ffpp2003/NPC/images/renders/ER3.png

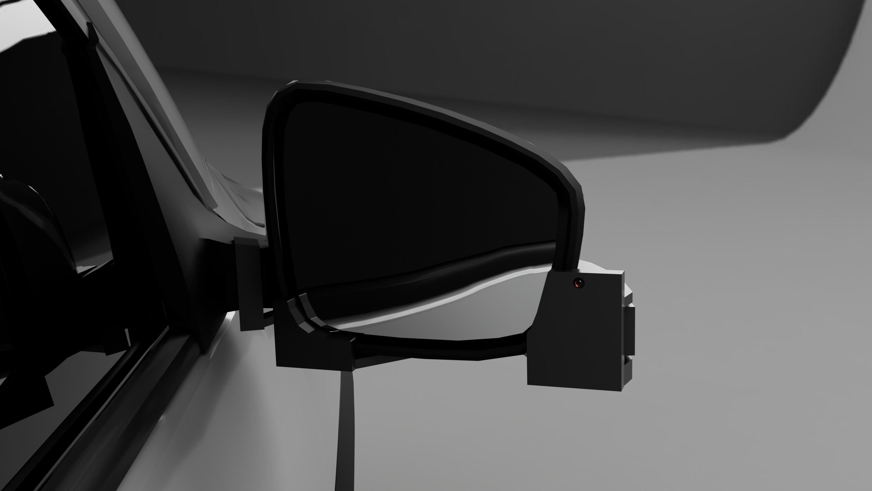
images/renders/ER3.png
