ffpp2003/NPC/images/renders/AL2.png

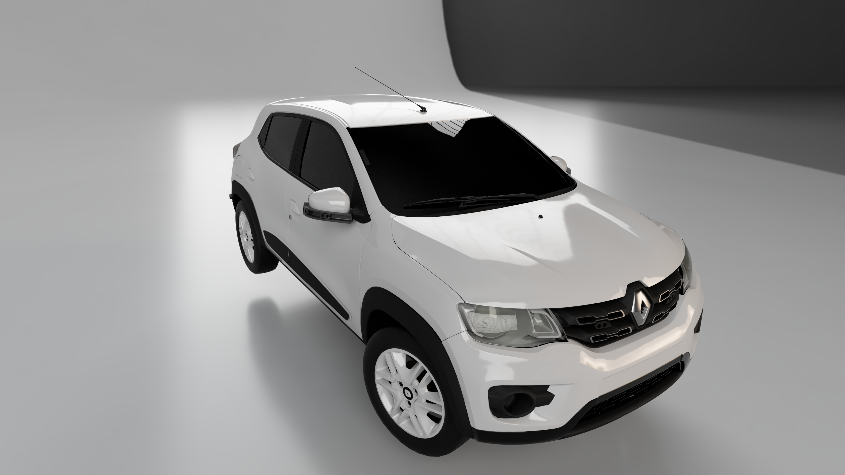
images/renders/AL2.png
