ffpp2003/NPC/README.md

# NPC
Demostracion conceptual funcional de un neutralizador de puntos ciegos para autos
