ffpp2003/NPC/images/renders/AL0.png

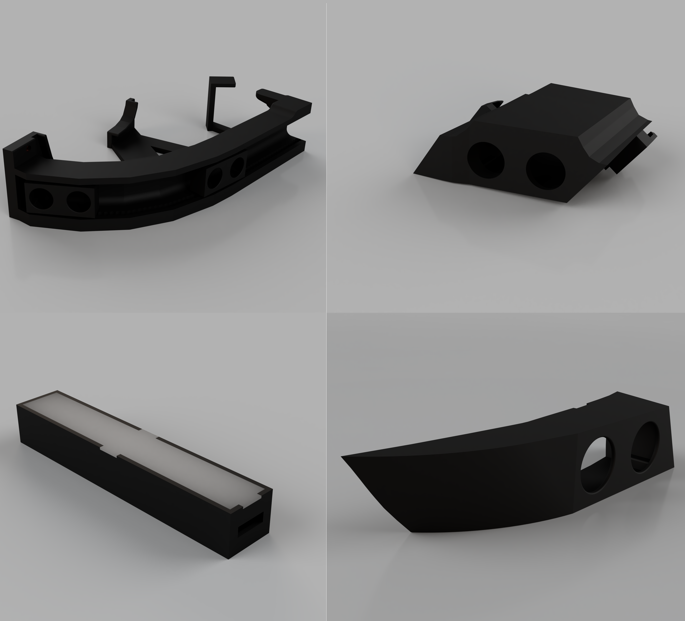
images/renders/AL0.png
