ffpp2003/NPC/images/renders/AL1.png

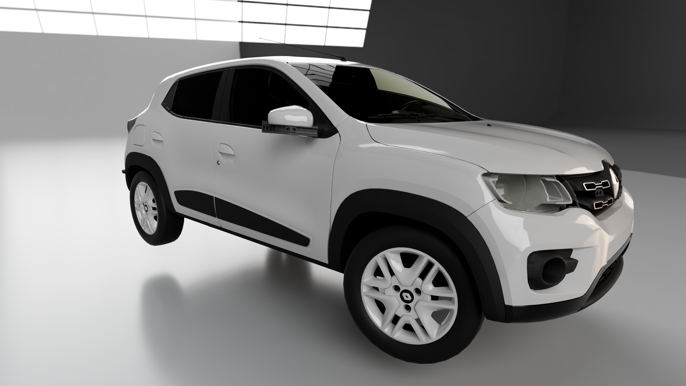
images/renders/AL1.png
