ffpp2003/NPC/images/renders/ER0.png

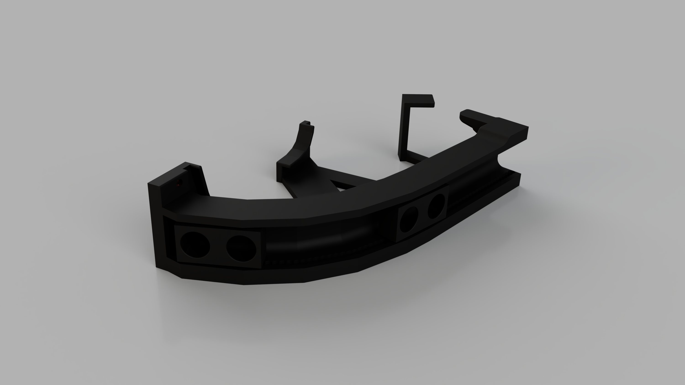
images/renders/ER0.png
