ffpp2003/NPC/images/renders/ER1.png

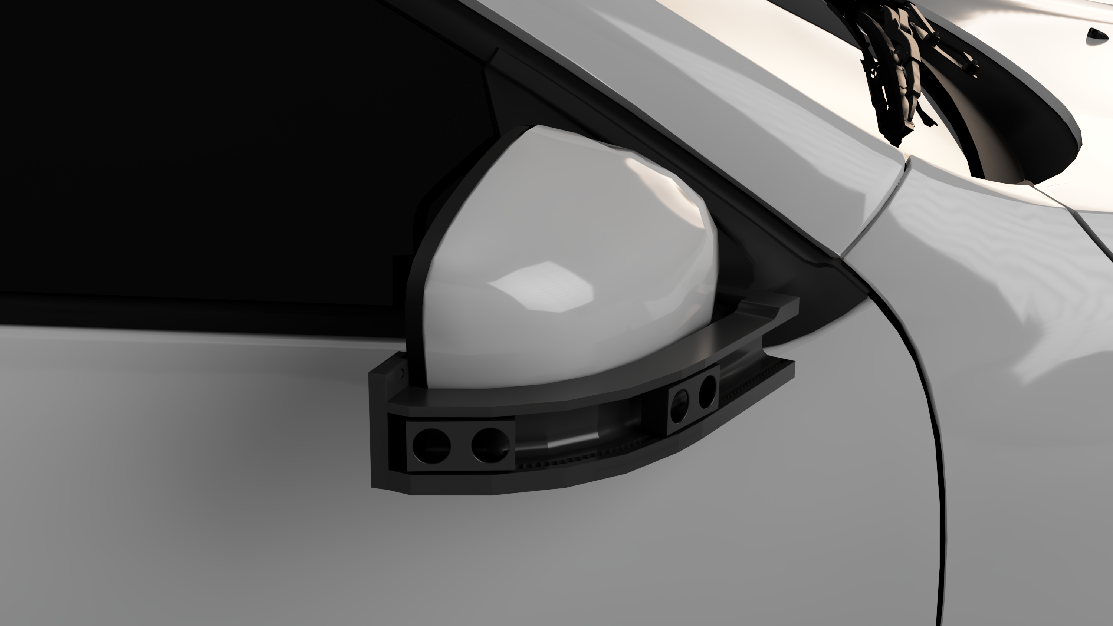
images/renders/ER1.png
