ffpp2003/NPC/images/renders/ER2.png

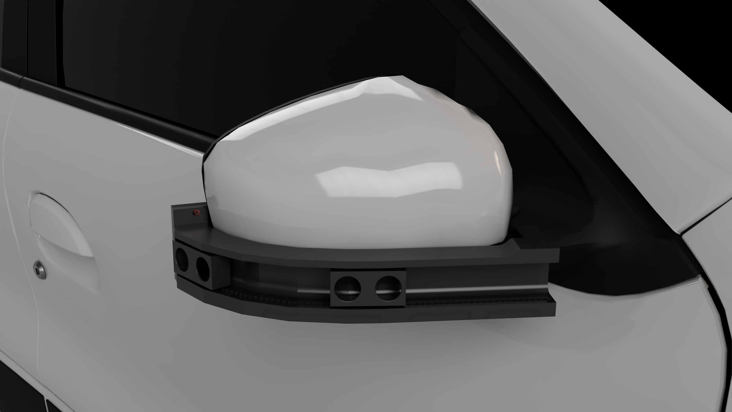
images/renders/ER2.png
