ffpp2003/NPC/images/renders/ER4.png

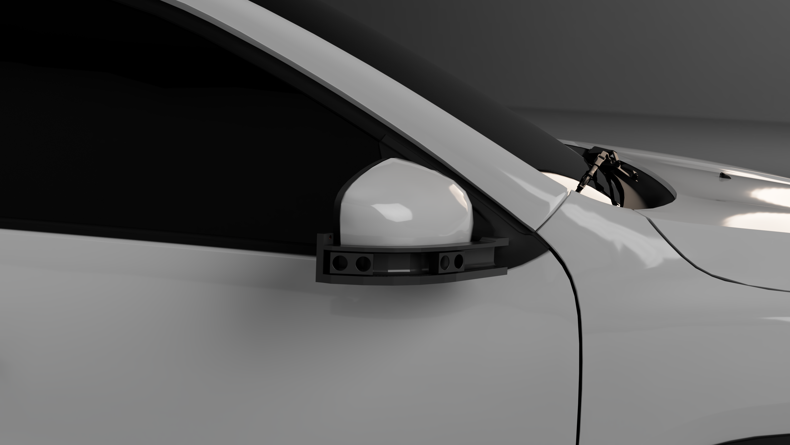
images/renders/ER4.png
