ffpp2003/NPC/images/renders/ER5.png

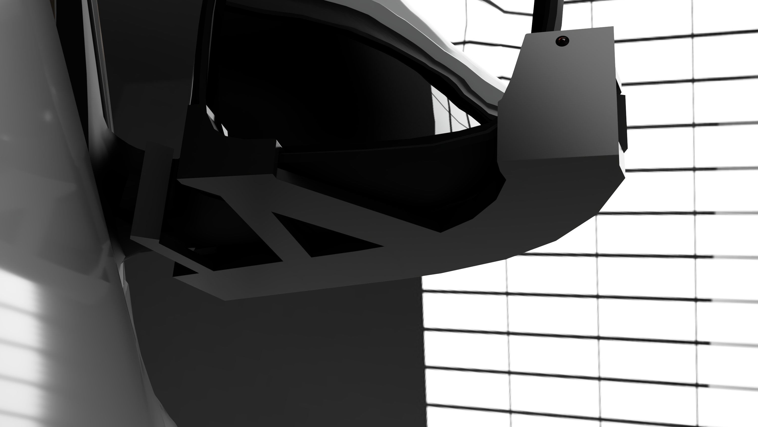
images/renders/ER5.png
