ffpp2003/NPC/images/renders/OP0.png

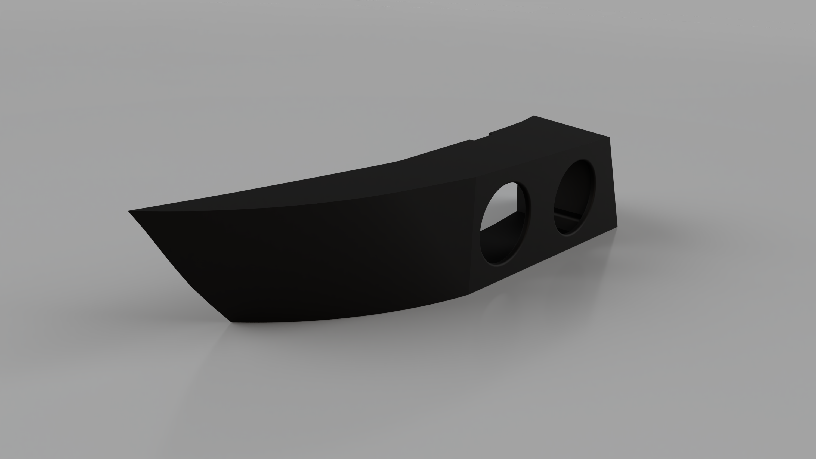
images/renders/OP0.png
