ffpp2003/NPC/images/renders/OP1.png

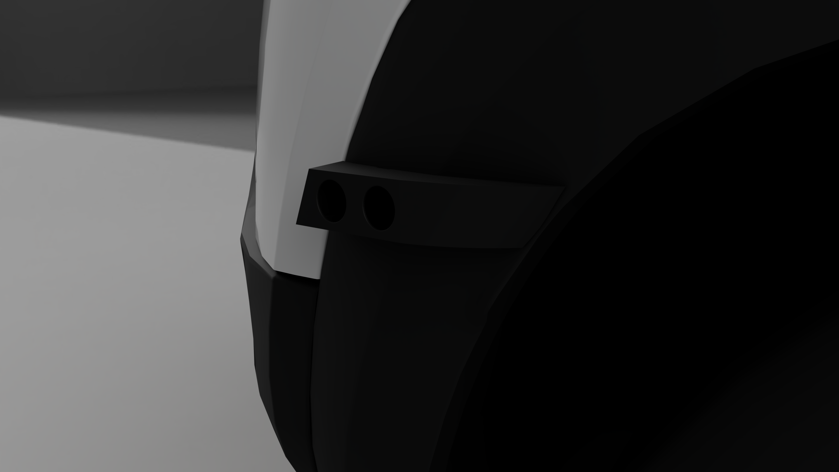
images/renders/OP1.png
