ffpp2003/NPC/images/renders/OP2.png

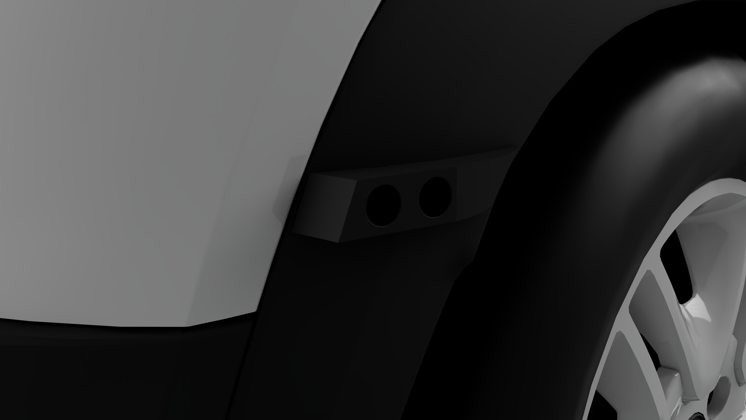
images/renders/OP2.png
