ffpp2003/NPC/images/renders/OP3.png

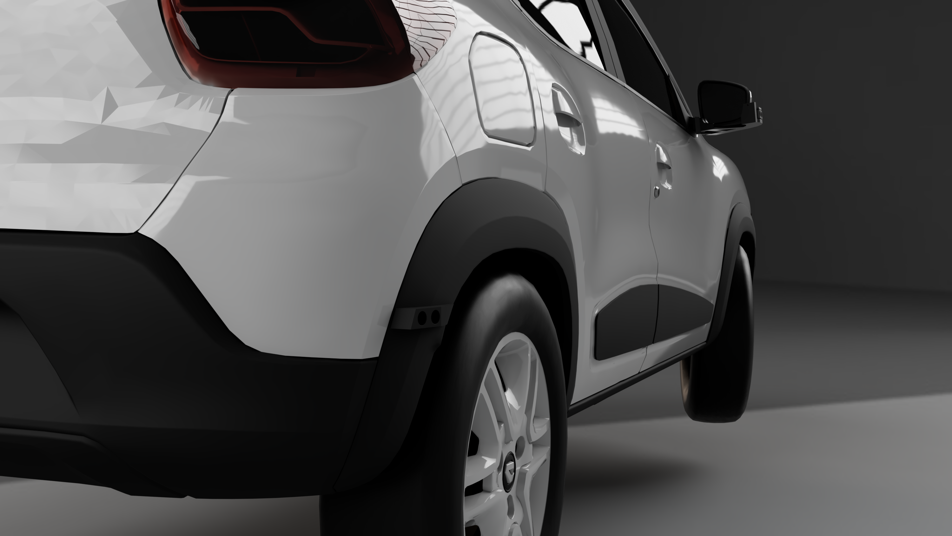
images/renders/OP3.png
