ffpp2003/NPC/images/renders/PCBL.png

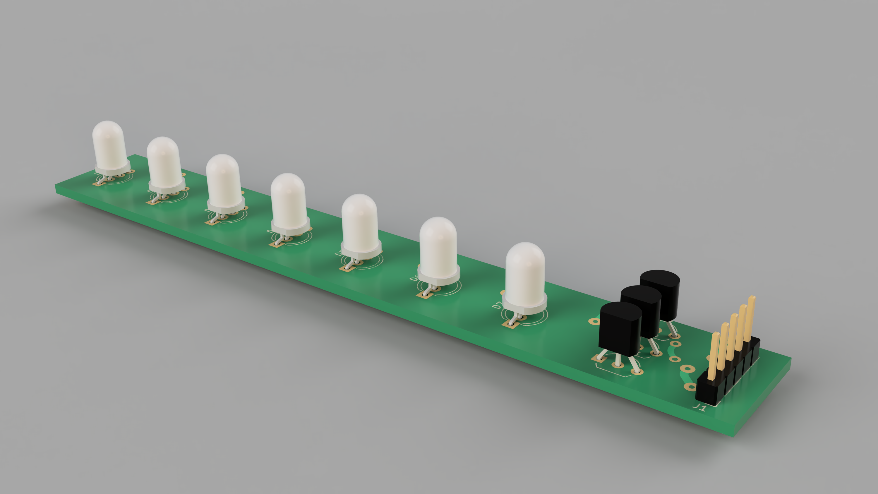
images/renders/PCBL.png
