ffpp2003/NPC/images/renders/PCBM.png

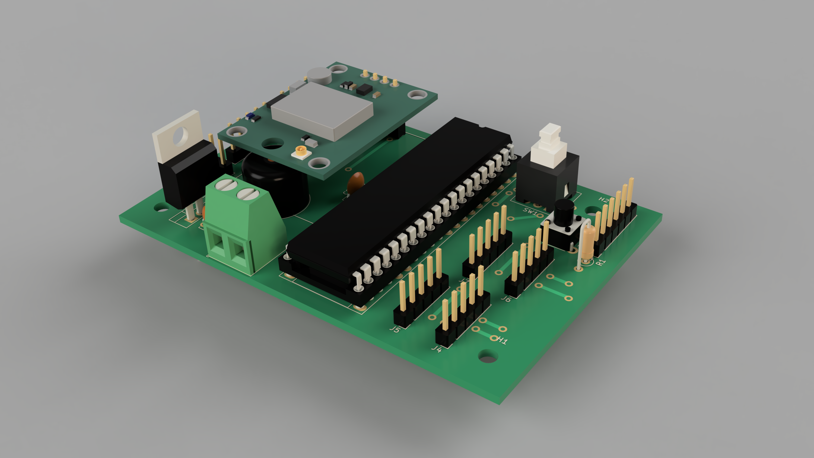
images/renders/PCBM.png
