ffpp2003/NPC/images/renders/PF0.png

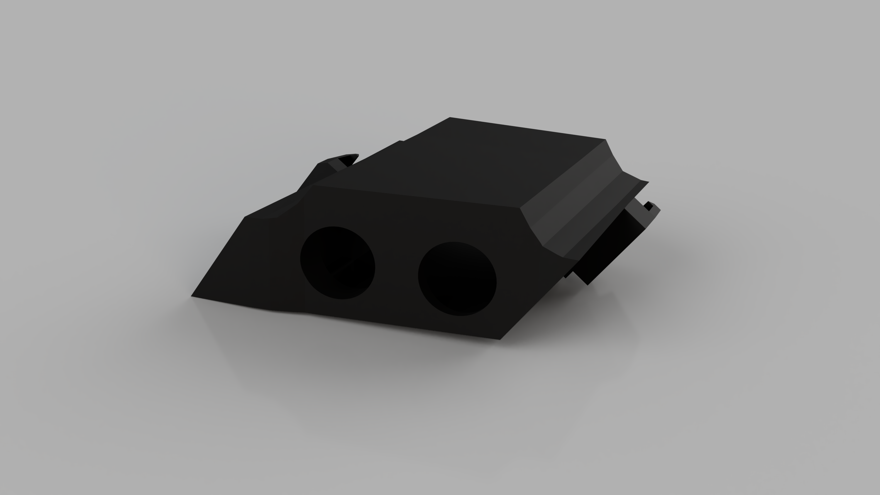
images/renders/PF0.png
