ffpp2003/NPC/images/renders/PF1.png

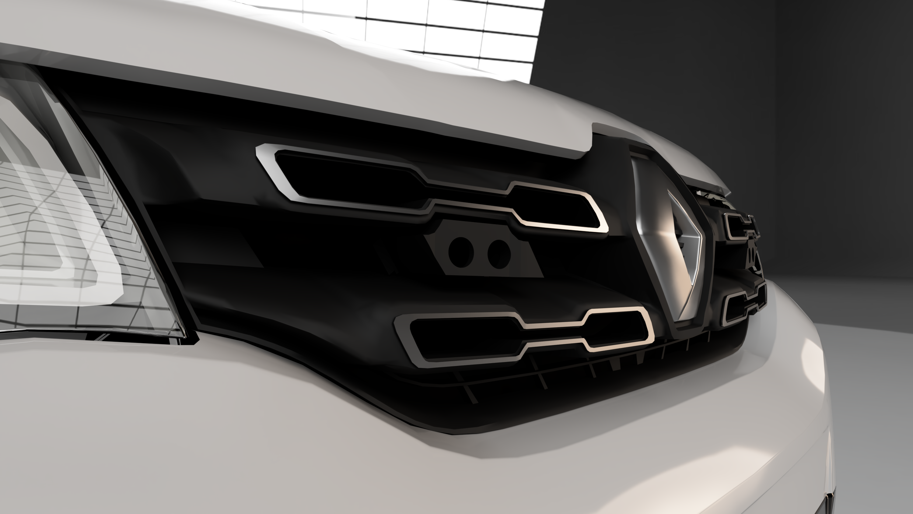
images/renders/PF1.png
