ffpp2003/NPC/images/renders/PF2.png

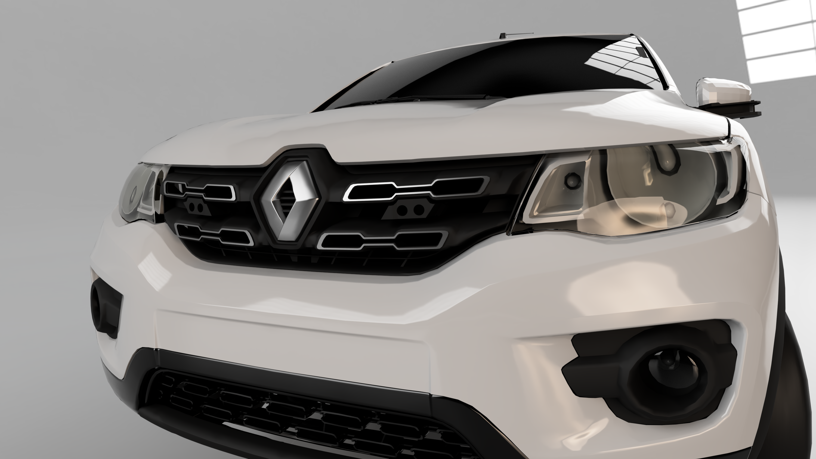
images/renders/PF2.png
