ffpp2003/NPC/images/renders/SL0.png

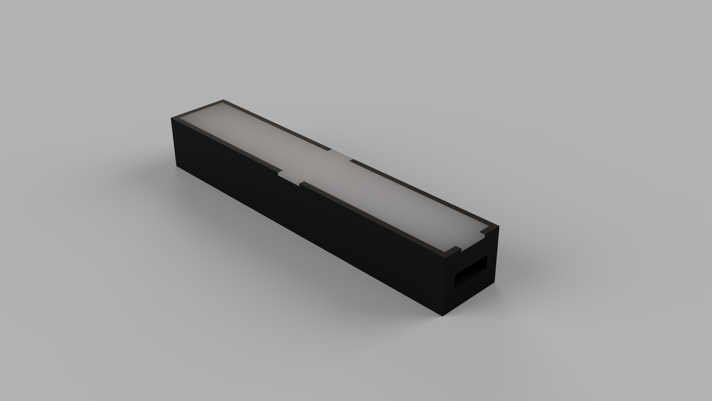
images/renders/SL0.png
