ffpp2003/NPC/images/renders/SL1.png

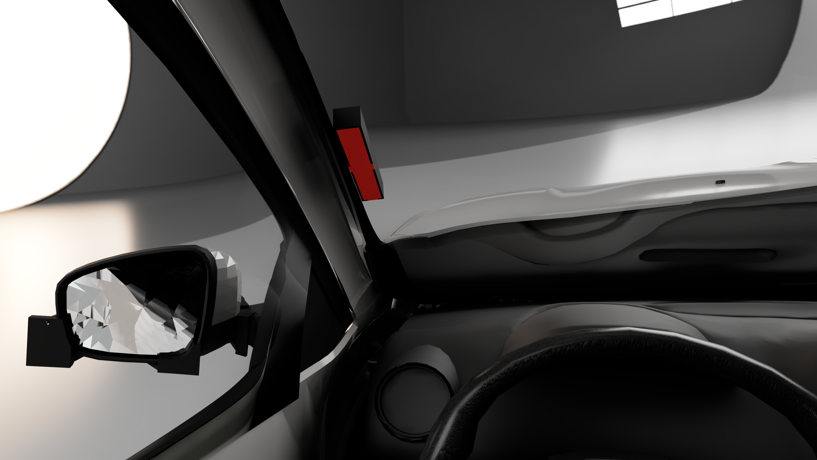
images/renders/SL1.png
