ffpp2003/NPC/images/renders/SL2.png

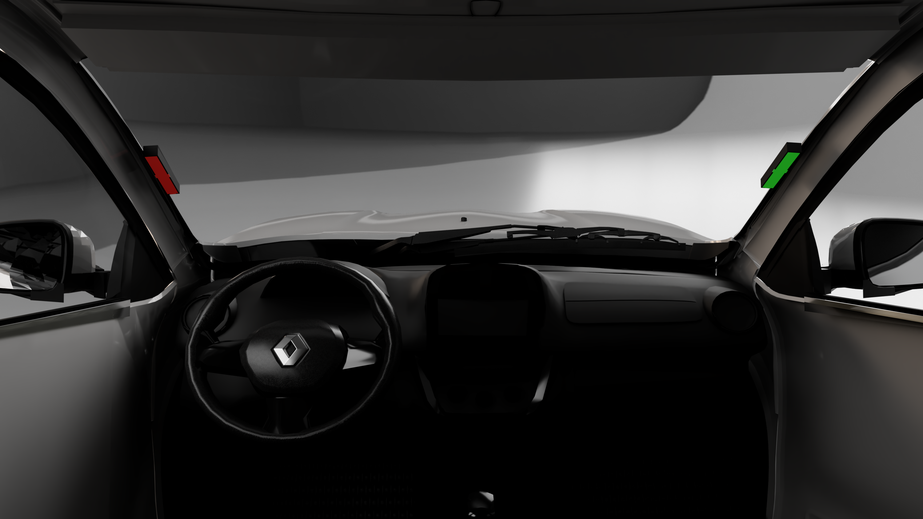
images/renders/SL2.png
