ffpp2003/NPC/src/Detector de puntos ciegos/GPS_ublox_board.STEP

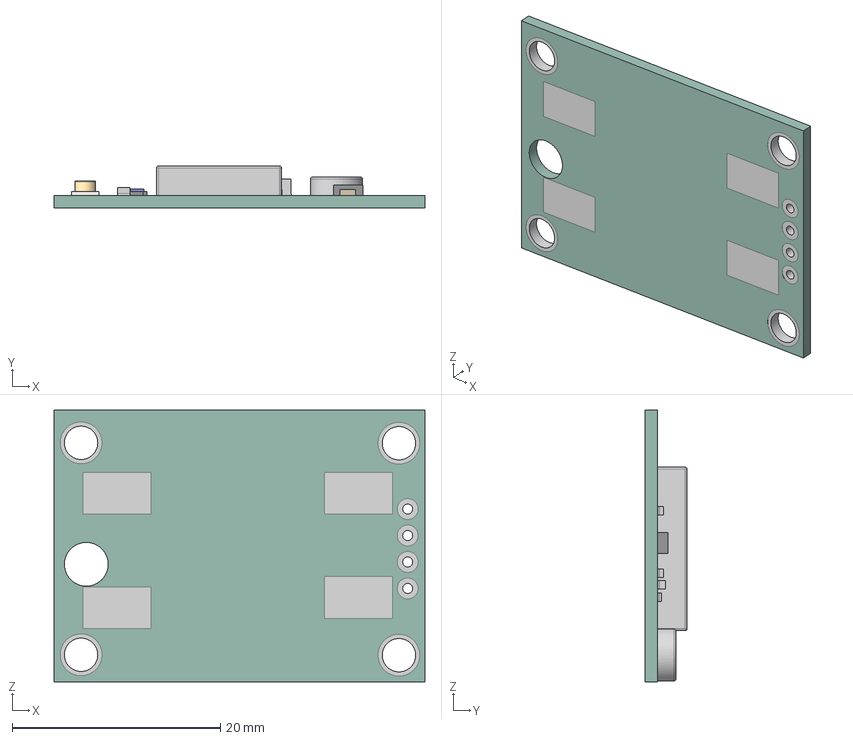
[picture p31: CAD file, 2022-11-30]
src/Detector de puntos ciegos/GPS_ublox_board.STEP
35.6 x 4.06 x 26.1 mm
