ffpp2003/NPC/src/PCB_LEDS/LED_D5.0mm-4_RGB_Wide_Pins-Body001.step

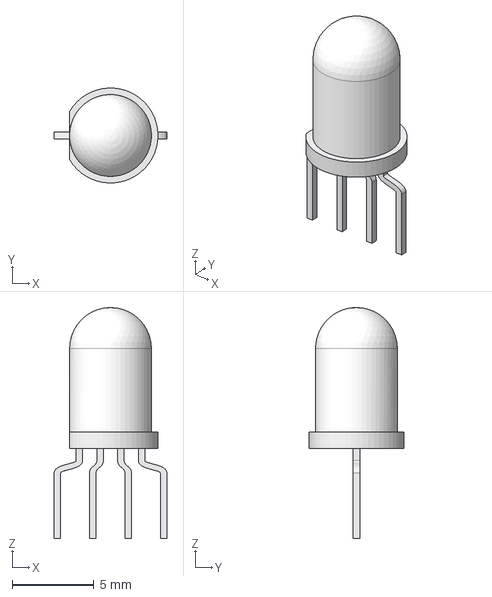
[picture p32: CAD file, 2022-11-30]
src/PCB_LEDS/LED_D5.0mm-4_RGB_Wide_Pins-Body001.step
6.88 x 5.79 x 14.1 mm
