ffpp2003/NPC/src/Detector de puntos ciegos/TL2230EEF100--3DModel-STEP-613395_2.step

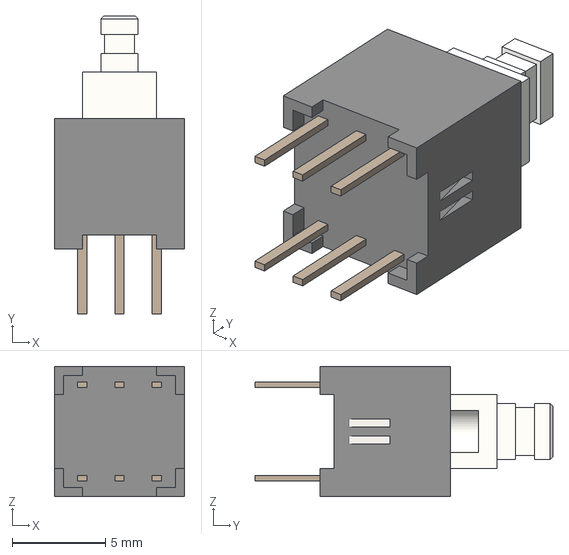
[picture p33: CAD file, 2022-11-30]
src/Detector de puntos ciegos/TL2230EEF100--3DModel-STEP-613395_2.step
7.00 x 16.0 x 7.00 mm
