ffpp2003/NPC/src/Detector de puntos ciegos/ublox NEO-6M.STEP

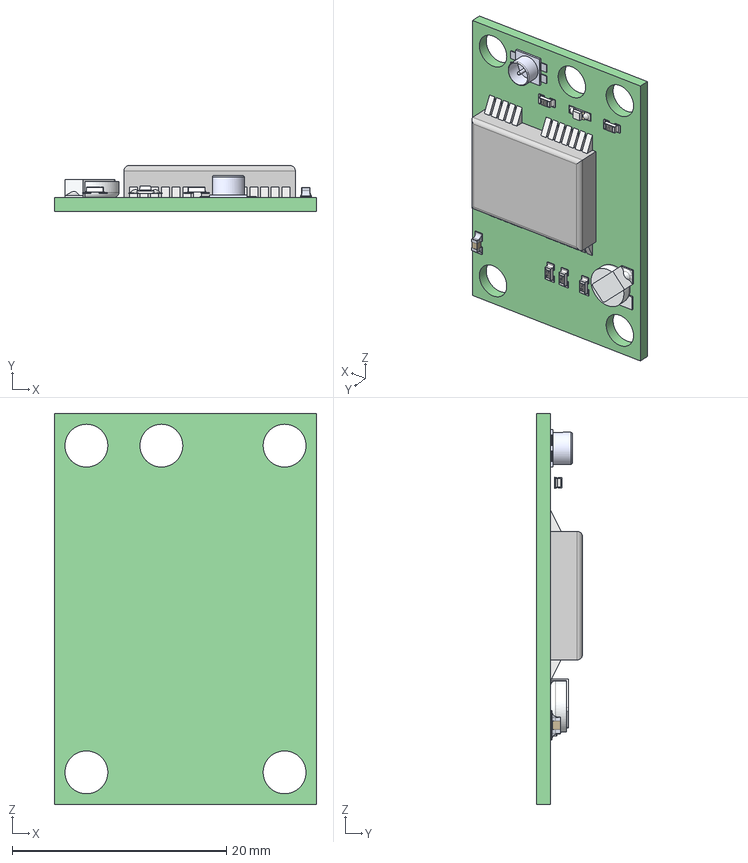
[picture p34: CAD file, 2022-11-30]
src/Detector de puntos ciegos/ublox NEO-6M.STEP
24.5 x 4.30 x 36.5 mm
GPS_pcb
GPS_cap
GPS_res221 x 2
GPS_res472 x 2
GPS_battery
GPS_res100
GPS_led
GPS_connector
