ffpp2003/NPC/src/Detector de puntos ciegos/Detector de puntos ciegos-User_Comments.dxf

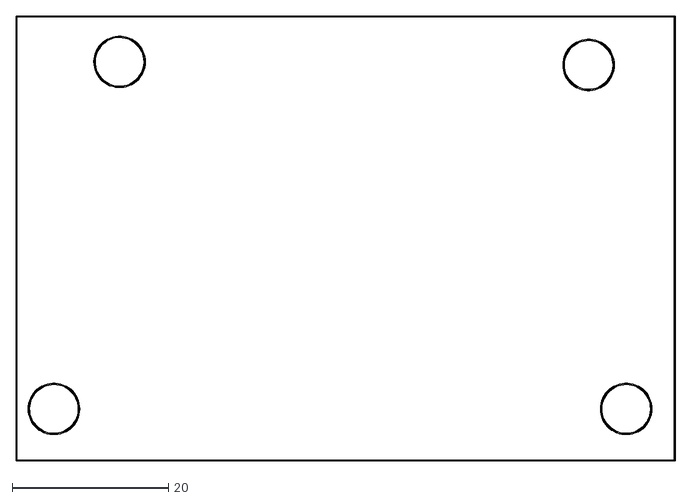
[picture p35: CAD file, 2022-11-23]
src/Detector de puntos ciegos/Detector de puntos ciegos-User_Comments.dxf
84.3 x 56.9
