ffpp2003/NPC/src/Detector de puntos ciegos/147694-1.step

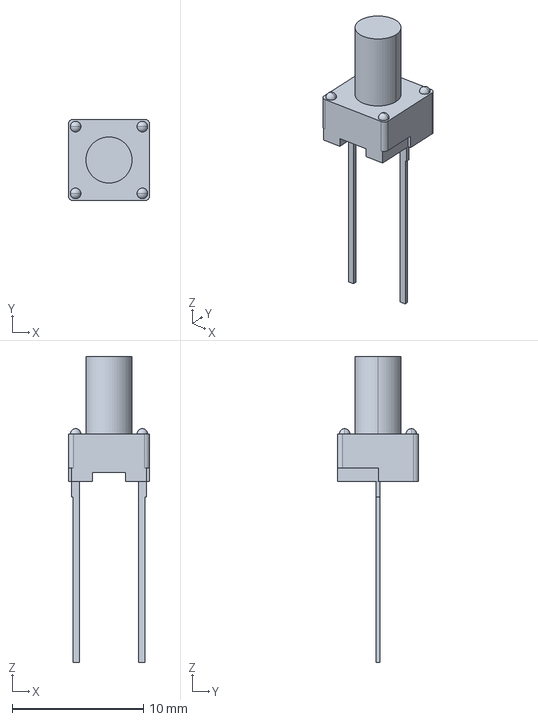
[picture p36: CAD file, 2022-11-23]
src/Detector de puntos ciegos/147694-1.step
6.20 x 6.20 x 23.3 mm
