ffpp2003/NPC/(list of files, cad)

Other CAD files:
src/Detector de puntos ciegos/TL2230EEF100--3DModel-STEP-613395.STEP
src/Detector de puntos ciegos/Detector de puntos ciegos-B_Silkscreen.dxf
src/Detector de puntos ciegos/Detector de puntos ciegos-F_Silkscreen.dxf
src/Models/PCB_LEDs.f3d
src/Models/PCB_Main.f3d
src/Models/Soporte_Adelantamient v7.f3d
src/Models/Soporte_EspejoRetrovisor v10.f3z
src/Models/Soporte_LEDs v2.f3d
src/Models/Soporte_Parrilla v11.f3z
src/PCB_LEDS/PCB_LEDS-B_Silkscreen.dxf
src/PCB_LEDS/PCB_LEDS-F_Silkscreen.dxf
