ffpp2003/NPC/src/Detector de puntos ciegos/Main_PCB_sch.pdf

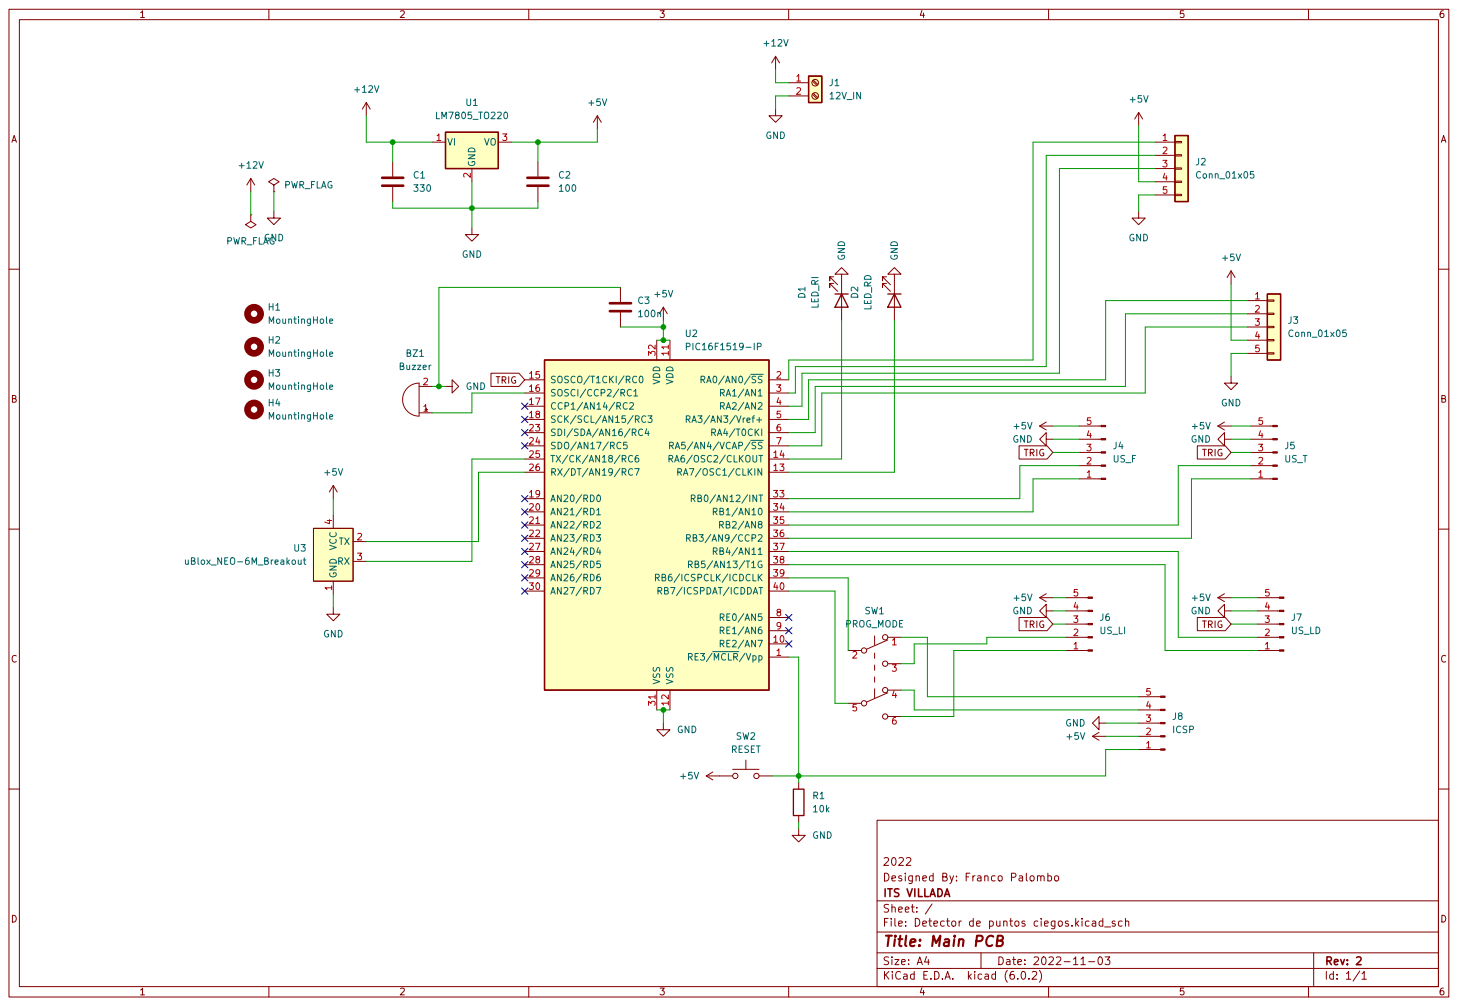
[picture p37: page 1]

Designed By: Franco Palombo
ITS VILLADA
File: Detector de puntos ciegos.kicad_sch Sheet: /
Id: 1/1 Title: Main PCB
