ffpp2003/NPC/src/PCB_LEDS/LEDs_PCB_sch.pdf

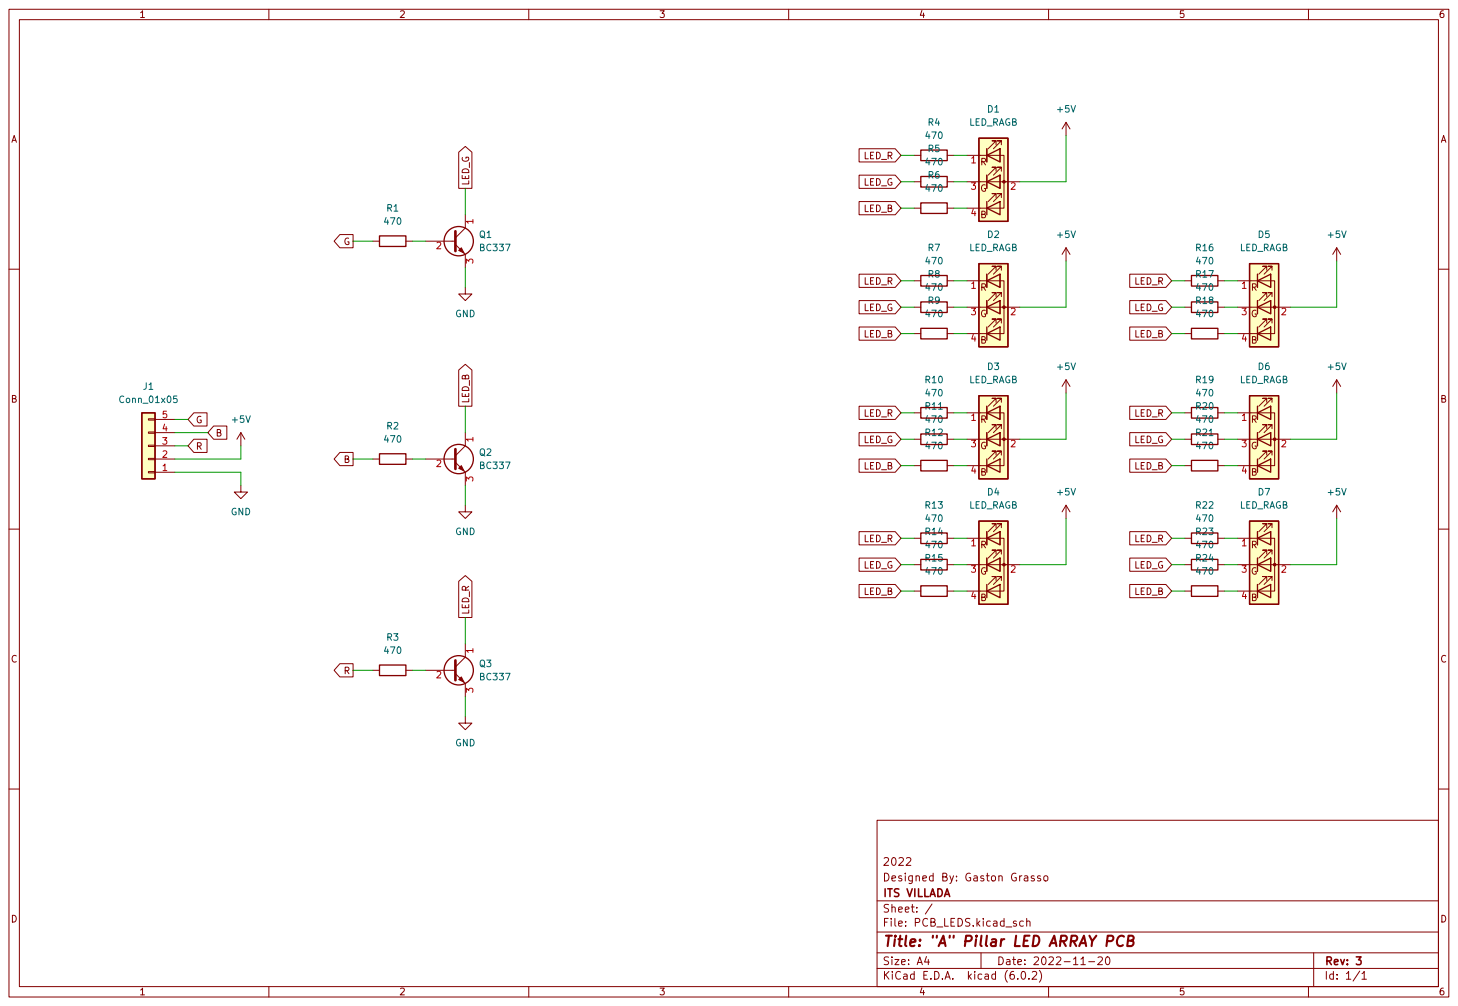
[picture p38: page 1]

Designed By: Gaston Grasso
ITS VILLADA
File: PCB_LEDS.kicad_sch Sheet: /
Id: 1/1 Title: "A" Pillar LED ARRAY PCB
