ffpp2003/NPC/src/Detector de puntos ciegos/Detector de puntos ciegos.kicad_pcb

## KiCad design src/Detector de puntos ciegos/Detector de puntos ciegos.kicad_pcb (2022-11-30)

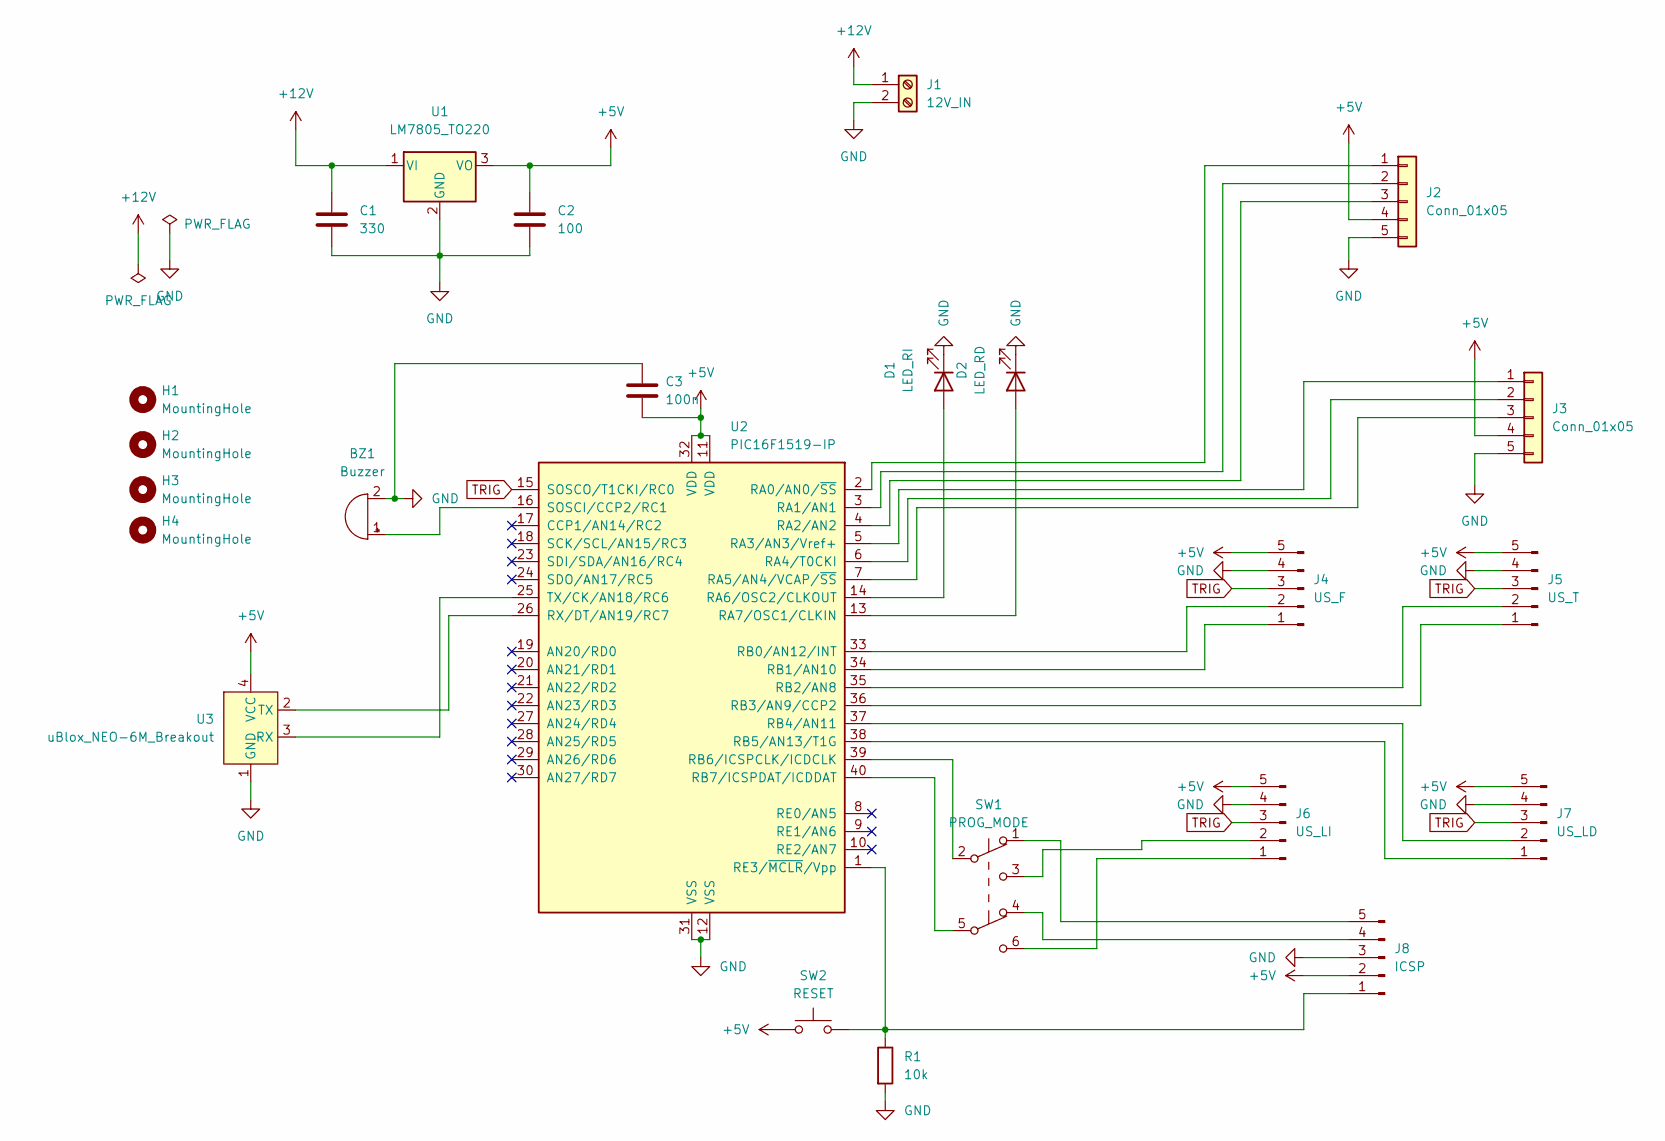
[picture p39: schematic Detector de puntos ciegos.kicad_sch]

Parts:
BZ1: Buzzer; Buzzer_12x9.5RM7.6
C1: 330; C_Disc_D5.0mm_W2.5mm_P5.00mm
C2: 100; C_Disc_D5.0mm_W2.5mm_P5.00mm
C3: 100n; C_Disc_D5.0mm_W2.5mm_P5.00mm
D1: LED_RI; PinHeader_1x02_P2.54mm_Vertical
D2: LED_RD; PinHeader_1x02_P2.54mm_Vertical
H1, H2, H3, H4: MountingHole; MountingHole_3.2mm_M3
J1: 12V_IN; TerminalBlock_Phoenix_MKDS-1,5-2-5.08_1x02_P5.08mm_Horizont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
J2, J3: Conn_01x05; PinHeader_1x05_P2.54mm_Vertical
J4: US_F; PinHeader_1x05_P2.54mm_Vertical
J5: US_T; PinHeader_1x05_P2.54mm_Vertical
J6: US_LI; PinHeader_1x05_P2.54mm_Vertical
J7: US_LD; PinHeader_1x05_P2.54mm_Vertical
J8: ICSP; PinHeader_1x06_P2.54mm_Vertical
R1: 10k; R_Axial_DIN0207_L6.3mm_D2.5mm_P2.54mm_Vertical
SW1: PROG_MODE; SW_Push_2P2T_Toggle_CK_PVA2OAH5xxxxxxV2
SW2: RESET; TE_FSM8JRT
U1: LM7805_TO220; TO-220-3_Vertical
U2: PIC16F1519-IP; DIP-40_W15.24mm_Socket_LongPads
U3: uBlox_NEO-6M_Breakout; uBlox-NEO-6M_Breakout

Connections:
+5V: C2.1, C3.1, J2.4, J3.4, J4.5, J5.5, J6.5, J7.5, J8.2, SW2.1, U1.3 (VO), U2.11 (VDD), U2.32 (VDD), U3.4 (VCC)
+12V: C1.1, J1.1, U1.1 (VI)
GND: BZ1.2 (+), C1.2, C2.2, C3.2, D1.1 (K), D2.1 (K), J1.2, J2.5, J3.5, J4.4, J5.4, J6.4, J7.4, J8.3, R1.2, U1.2 (GND), U2.12 (VSS), U2.31 (VSS), U3.1 (GND)
unnamed: BZ1.1 (-), U2.16 (SOSCI/CCP2/RC1)
unnamed: D1.2 (A), U2.14 (RA6/OSC2/CLKOUT)
unnamed: D2.2 (A), U2.13 (RA7/OSC1/CLKIN)
unnamed: J2.1, U2.2 (RA0/AN0/~SS)
unnamed: J2.2, U2.3 (RA1/AN1)
unnamed: J2.3, U2.4 (RA2/AN2)
unnamed: J3.1, U2.5 (RA3/AN3/Vref+)
unnamed: J3.2, U2.6 (RA4/T0CKI)
unnamed: J3.3, U2.7 (RA5/AN4/VCAP/~SS)
unnamed: J4.1, U2.34 (RB1/AN10)
unnamed: J4.2, U2.33 (RB0/AN12/INT)
unnamed: J5.1, U2.36 (RB3/AN9/CCP2)
unnamed: J5.2, U2.35 (RB2/AN8)
unnamed: J6.1, SW1.6 (C)
unnamed: J6.2, SW1.3 (C)
unnamed: J7.1, U2.38 (RB5/AN13/T1G)
unnamed: J7.2, U2.37 (RB4/AN11)
unnamed: J8.1, R1.1, SW2.2, U2.1 (RE3/~MCLR/Vpp)
unnamed: J8.4, SW1.4 (A)
unnamed: J8.5, SW1.1 (A)
unnamed: SW1.2 (B), U2.39 (RB6/ICSPCLK/ICDCLK)
unnamed: SW1.5 (B), U2.40 (RB7/ICSPDAT/ICDDAT)
unnamed: U2.25 (TX/CK/AN18/RC6), U3.3 (RX)
unnamed: U2.26 (RX/DT/AN19/RC7), U3.2 (TX)
TRIG: J4.3, J5.3, J6.3, J7.3, U2.15 (SOSCO/T1CKI/RC0)

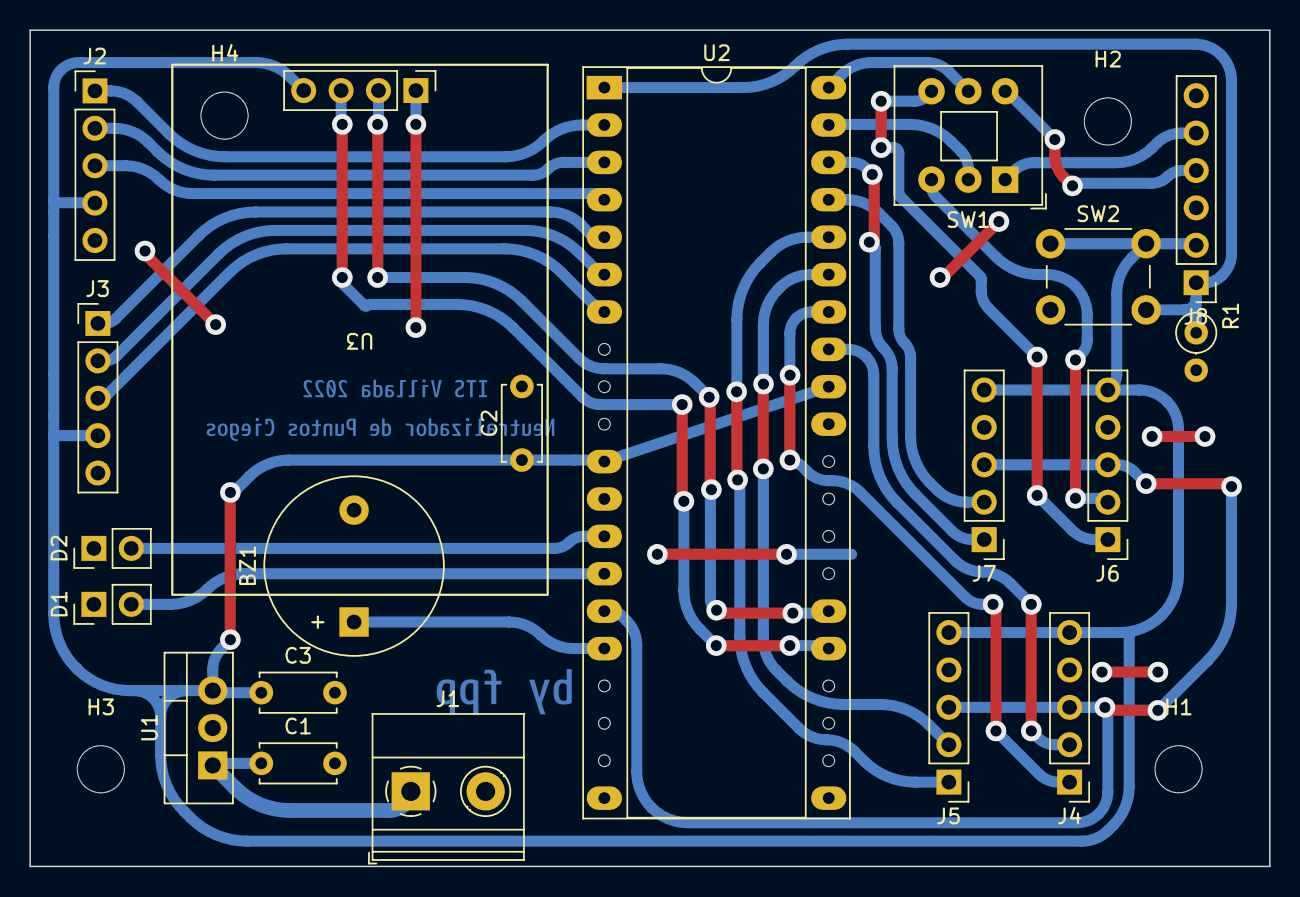
[picture p40: board Detector de puntos ciegos.kicad_pcb from above]

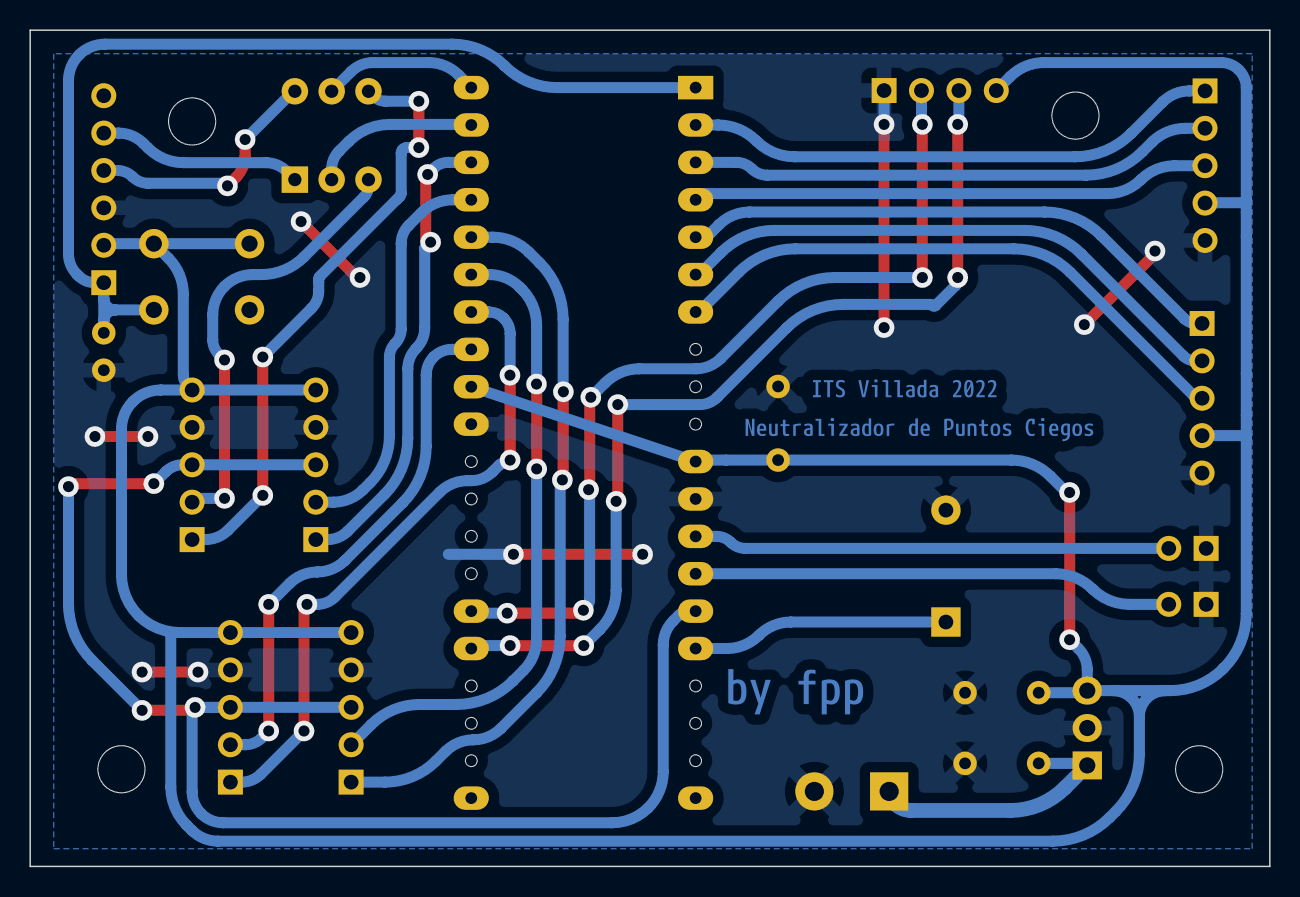
[picture p41: board Detector de puntos ciegos.kicad_pcb from below]

Board: 2 copper layers, 84.2 x 56.8 mm, 27 parts (3 on the bottom side), 28 nets.

Other parts of the board:
kibuzzard-636CFA59: G***; kibuzzard-636CFA59
kibuzzard-636CFA96: G***; kibuzzard-636CFA96
kibuzzard-636CFAAE: G***; kibuzzard-636CFAAE
