ffpp2003/NPC/src/PCB_LEDS/PCB_LEDS.kicad_pcb

## KiCad design src/PCB_LEDS/PCB_LEDS.kicad_pcb (2022-11-30)

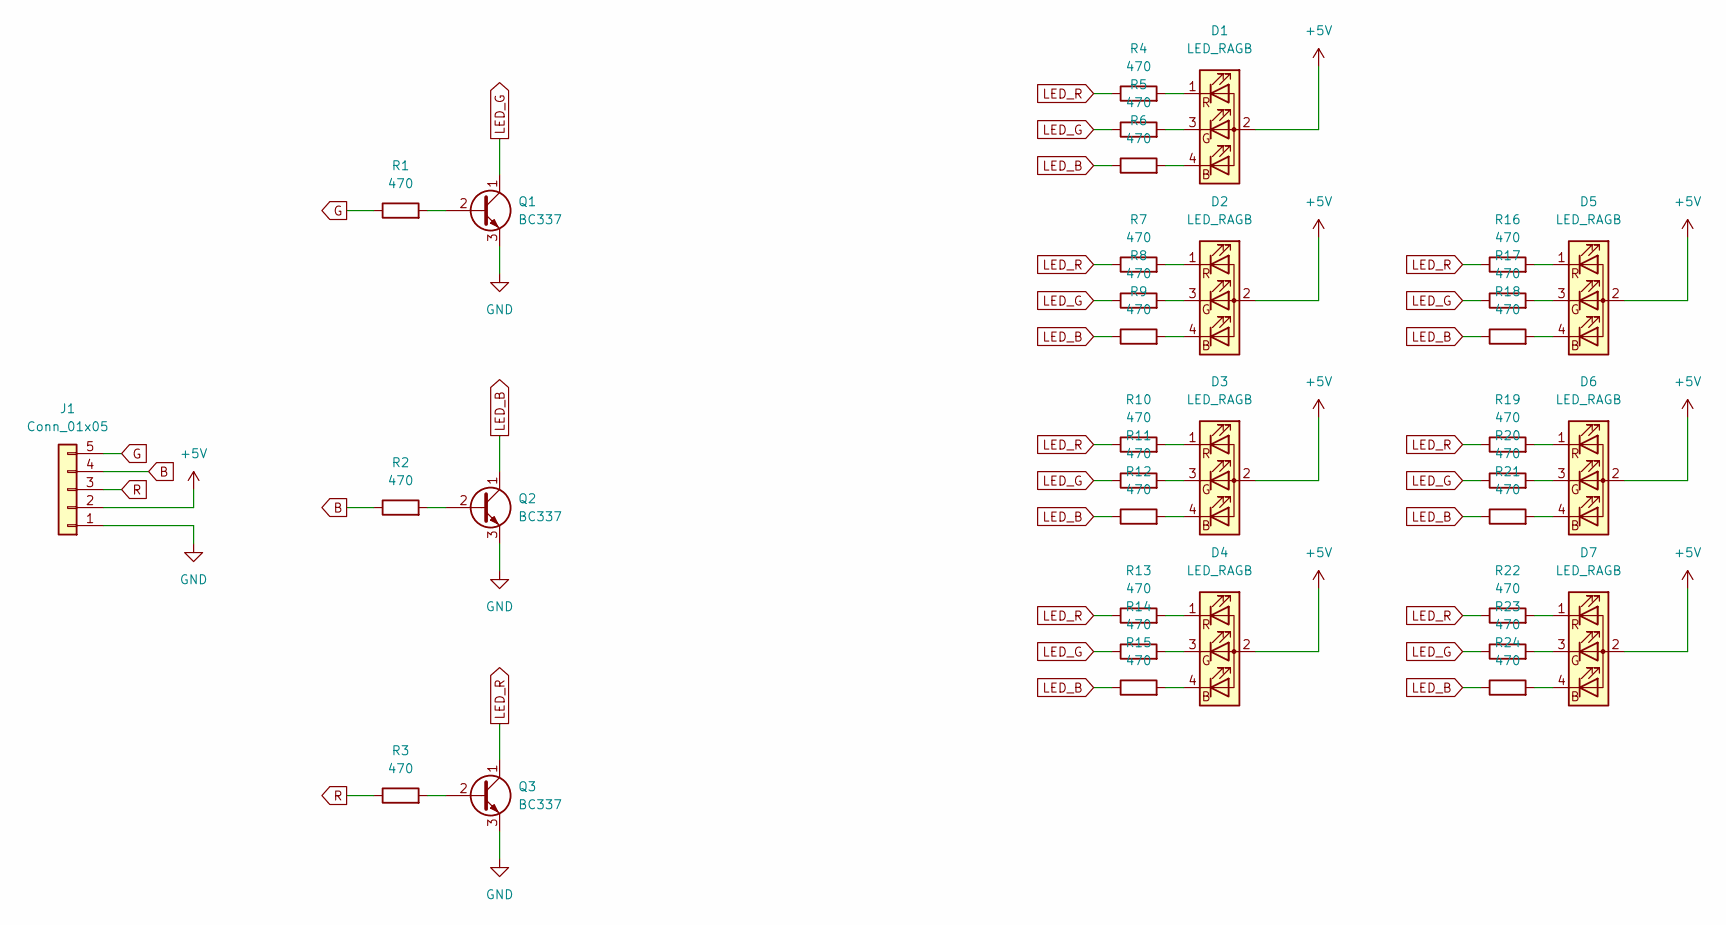
[picture p42: schematic PCB_LEDS.kicad_sch, "A" Pillar LED ARRAY PCB]

Parts:
D1, D2, D3, D4, D5, D6, D7: LED_RAGB; LED_D5.0mm-4_RGB_Wide_Pins
J1: Conn_01x05; PinHeader_1x05_P2.54mm_Vertical
Q1, Q2, Q3: BC337; TO-92_Inline_Wide
R1, R2, R3, R4, R5, R6, R7, R8, R9, R10, R11, R12, R13, R14, R15, R16, R17, R18, R19, R20, R21, R22, R23, R24: 470; R_0603_1608Metric_Pad0.98x0.95mm_HandSolder

Connections:
+5V: D1.2 (A), D2.2 (A), D3.2 (A), D4.2 (A), D5.2 (A), D6.2 (A), D7.2 (A), J1.2
B: J1.4, R2.1
G: J1.5, R1.1
GND: J1.1, Q1.3 (E), Q2.3 (E), Q3.3 (E)
LED_B: Q2.1 (C), R6.1, R9.1, R12.1, R15.1, R18.1, R21.1, R24.1
LED_G: Q1.1 (C), R5.1, R8.1, R11.1, R14.1, R17.1, R20.1, R23.1
LED_R: Q3.1 (C), R4.1, R7.1, R10.1, R13.1, R16.1, R19.1, R22.1
unnamed: D1.1 (RK), R4.2
unnamed: D1.3 (GK), R5.2
unnamed: D1.4 (BK), R6.2
unnamed: D2.1 (RK), R7.2
unnamed: D2.3 (GK), R8.2
unnamed: D2.4 (BK), R9.2
unnamed: D3.1 (RK), R10.2
unnamed: D3.3 (GK), R11.2
unnamed: D3.4 (BK), R12.2
unnamed: D4.1 (RK), R13.2
unnamed: D4.3 (GK), R14.2
unnamed: D4.4 (BK), R15.2
unnamed: D5.1 (RK), R16.2
unnamed: D5.3 (GK), R17.2
unnamed: D5.4 (BK), R18.2
unnamed: D6.1 (RK), R19.2
unnamed: D6.3 (GK), R20.2
unnamed: D6.4 (BK), R21.2
unnamed: D7.1 (RK), R22.2
unnamed: D7.3 (GK), R23.2
unnamed: D7.4 (BK), R24.2
unnamed: Q1.2 (B), R1.2
unnamed: Q2.2 (B), R2.2
unnamed: Q3.2 (B), R3.2
R: J1.3, R3.1

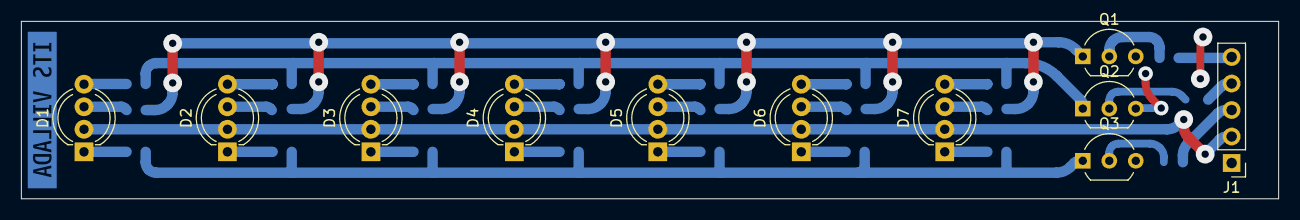
[picture p43: board PCB_LEDS.kicad_pcb from above]

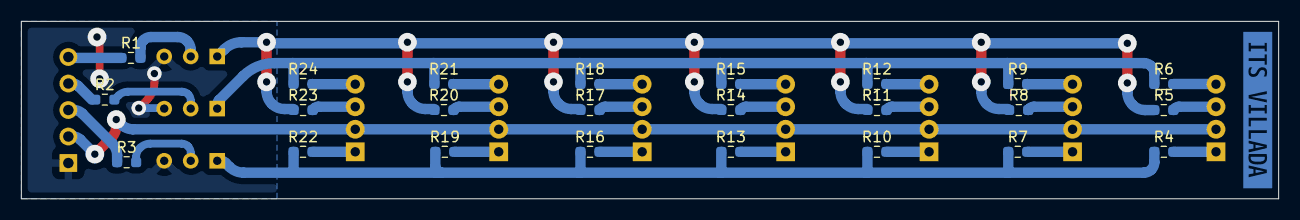
[picture p44: board PCB_LEDS.kicad_pcb from below]

Board: 2 copper layers, 120.5 x 17.0 mm, 36 parts (25 on the bottom side), 32 nets.

Other parts of the board:
kibuzzard-6352A8D4: G***; kibuzzard-6352A8D4
