ffpp2003/NPC/src/Detector de puntos ciegos/Detector de puntos ciegos_886.kicad_pcb

## KiCad design src/Detector de puntos ciegos/Detector de puntos ciegos_886.kicad_pcb (2022-11-23)

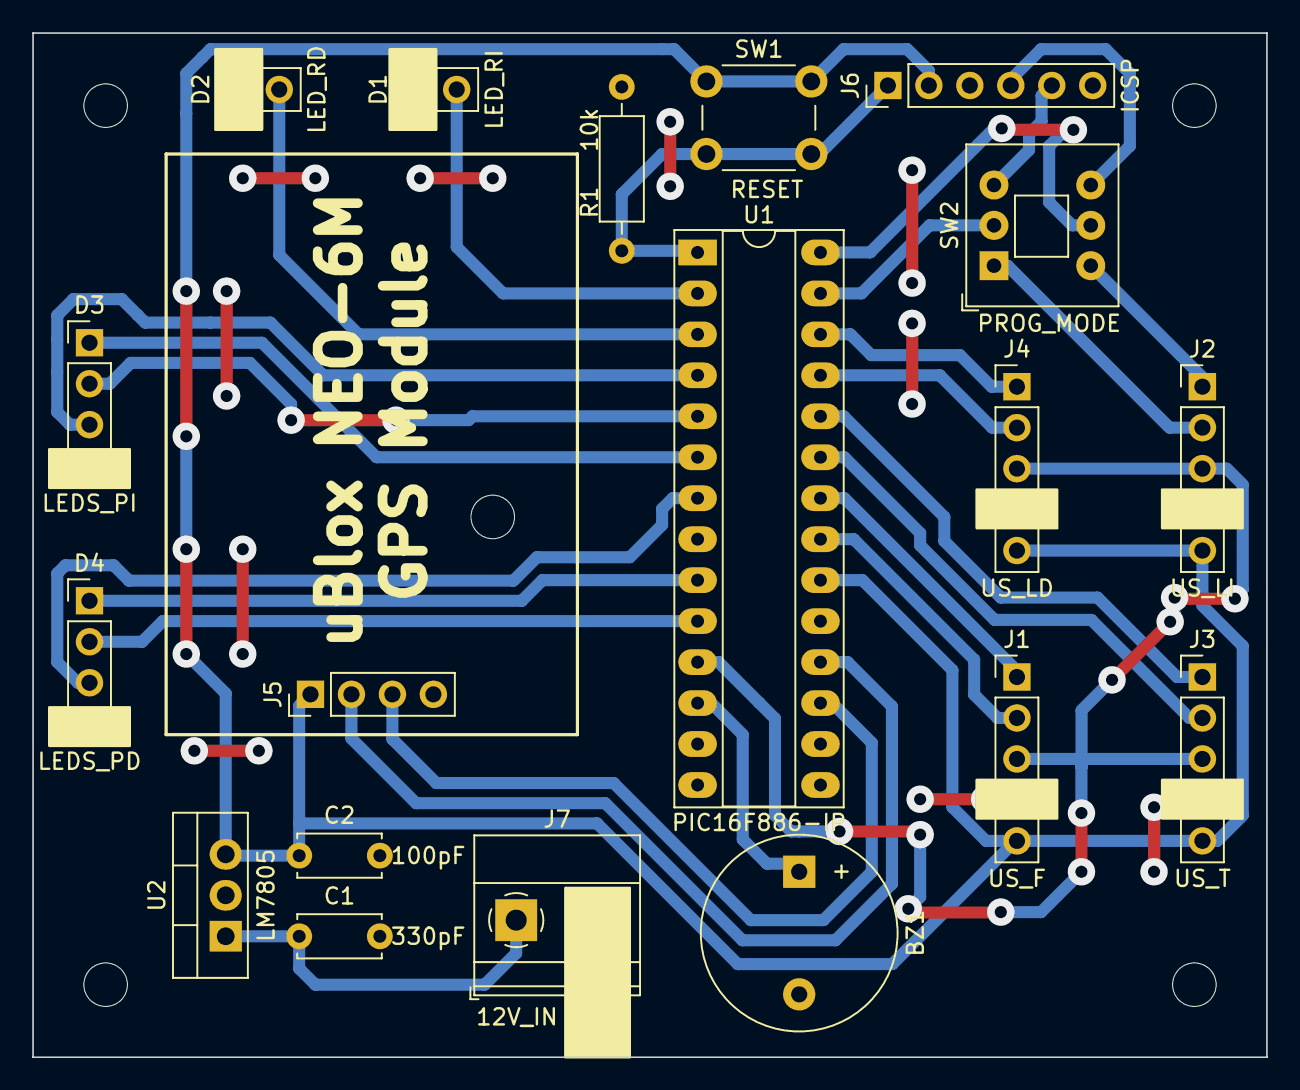
[picture p45: board Detector de puntos ciegos_886.kicad_pcb from above]

Board: 2 copper layers, 76.5 x 63.5 mm, 19 parts (0 on the bottom side), 28 nets.

Parts:
BZ1: Buzzer; Buzzer_12x9.5RM7.6
C1: 330pF; C_Disc_D5.0mm_W2.5mm_P5.00mm
C2: 100pF; C_Disc_D5.0mm_W2.5mm_P5.00mm
D1: LED_RI; PinHeader_1x02_P2.54mm_Vertical
D2: LED_RD; PinHeader_1x02_P2.54mm_Vertical
D3: LEDS_PI; PinHeader_1x04_P2.54mm_Vertical
D4: LEDS_PD; PinHeader_1x04_P2.54mm_Vertical
J1: US_F; PinHeader_1x05_P2.54mm_Vertical
J2: US_LI; PinHeader_1x05_P2.54mm_Vertical
J3: US_T; PinHeader_1x05_P2.54mm_Vertical
J4: US_LD; PinHeader_1x05_P2.54mm_Vertical
J5: GPS; PinHeader_1x04_P2.54mm_Vertical
J6: ICSP; PinHeader_1x06_P2.54mm_Vertical
J7: 12V_IN; TerminalBlock_Phoenix_MKDS-1,5-2-5.08_1x02_P5.08mm_Horizont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
R1: 10k; R_Axial_DIN0207_L6.3mm_D2.5mm_P10.16mm_Horizontal
SW1: RESET; SW_PUSH_6mm_H5mm
SW2: PROG_MODE; SW_Push_2P2T_Toggle_CK_PVA2OAH5xxxxxxV2
U1: PIC16F886-IP; DIP-28_W7.62mm_Socket_LongPads
U2: LM7805; TO-220-3_Vertical

Connections:
+5V: C2.1, J1.5, J2.5, J3.5, J4.5, J5.1, J6.2, SW1.1, U1.20 (VDD), U2.3 (VO)
+12V: C1.1, J7.1, U2.1 (VI)
GND: BZ1.2 (+), C1.2, C2.2, D1.1 (K), D2.1 (K), D3.4 (K), D4.4 (K), J1.4, J2.4, J3.4, J4.4, J5.4, J6.3, J7.2, R1.2, U1.8 (VSS), U1.19 (VSS), U2.2 (GND)
unnamed: BZ1.1 (-), U1.12 (RC1/T1OSI/CCP2)
unnamed: D1.2 (A), U1.2 (ULPWU/C12IN0-/AN0/RA0)
unnamed: D2.2 (A), U1.3 (C12IN1-/AN1/RA1)
unnamed: D3.1 (RA), U1.6 (T0CKI/C1OUT/RA4)
unnamed: D3.2 (GA), U1.5 (C1IN+/Vref+/AN3/RA3)
unnamed: D3.3 (BA), U1.4 (CVref/C2IN1+/Vref-/AN2/RA2)
unnamed: D4.1 (RA), U1.9 (CLKIN/OSC1/RA7)
unnamed: D4.2 (GA), U1.10 (CLKOUT/OSC2/RA6)
unnamed: D4.3 (BA), U1.7 (~SS/C2OUT/AN4/RA5)
unnamed: J1.1, U1.22 (P1C/AN10/RB1)
unnamed: J1.2, U1.21 (INT/AN12/RB0)
unnamed: J2.1, SW2.4 (A)
unnamed: J2.2, SW2.1 (A)
unnamed: J3.1, U1.24 (PGM/C12IN2-/AN8/RB3)
unnamed: J3.2, U1.23 (P1B/AN8/RB2)
unnamed: J4.1, U1.26 (~T1G/AN13/RB5)
unnamed: J4.2, U1.25 (P1D/AN11/RB4)
unnamed: J6.1, R1.1, SW1.2, U1.1 (RE3/~MCLR/Vpp)
unnamed: J6.4, SW2.6 (C)
unnamed: J6.5, SW2.3 (C)
unnamed: SW2.2 (B), U1.27 (ICSPCLK/RB6)
unnamed: SW2.5 (B), U1.28 (ICSPDAT/RB7)
RX: J5.2, U1.18 (RC7/RX/DT)
TRIG: J1.3, J2.3, J3.3, J4.3, U1.11 (RC0/T1OSO/T1CK1)
TX: J5.3, U1.17 (RC6/TX/CK)
