ffpp2003/NPC/(commit log)

2022-11-23 Main PCB
    [147694-1.step, Detector de puntos ciegos-User_Comments.dxf, Detector de puntos ciegos.csv, Detector de puntos ciegos.kicad_pcb, Detector de puntos ciegos.kicad_sch, Detector de puntos ciegos_886.kicad_pcb]
2022-11-23 LED PCB
    [PCB_LEDS.kicad_pcb, PCB_LEDS.kicad_sch]
2022-11-23 Files created with Fusion 360 personal licence
    [Soporte_Adelantamient v7.f3d, Soporte_EspejoRetrovisor v10.f3z, Soporte_LEDs v2.f3d, Soporte_Parrilla v11.f3z]
2022-11-23 Made with google forms
    [Encuesta_ conduccion.puntos.ciegos.csv]
